andrewnguyen57/stm32-chess-arm/hardware/REV1.md

## Revision 1 of the PCB

### Control 
<p align="center">
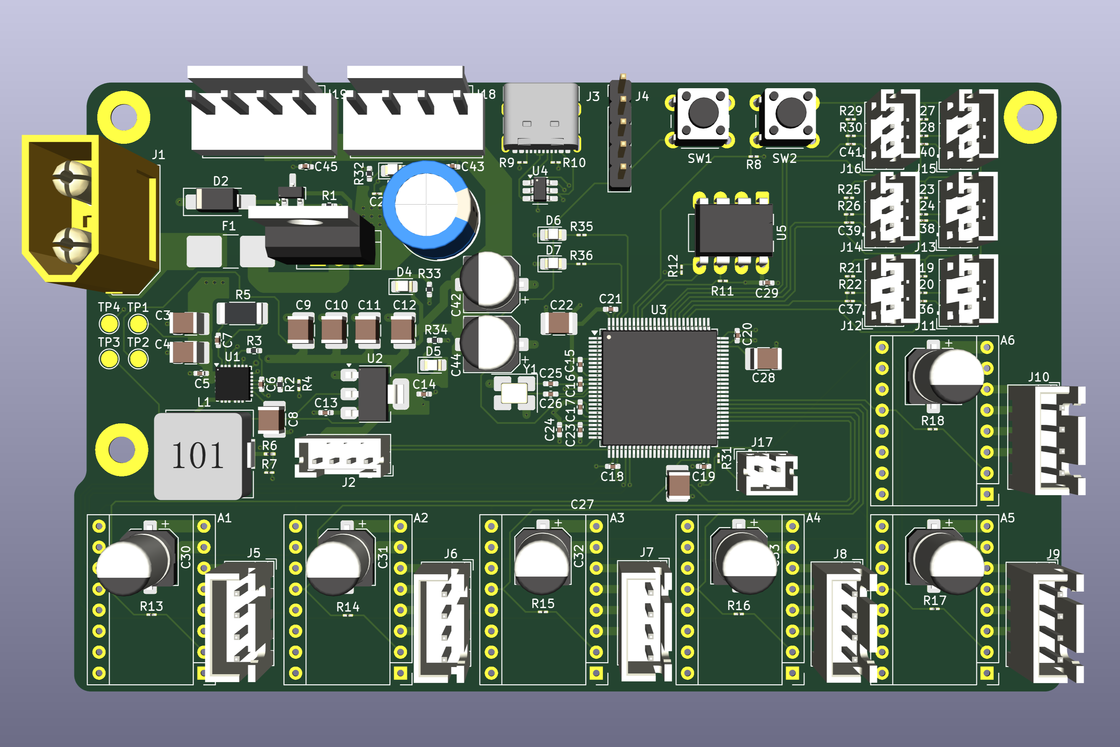
[picture p9: docs/images/pcb-3d_rev1.png]
Control Board 3D
  
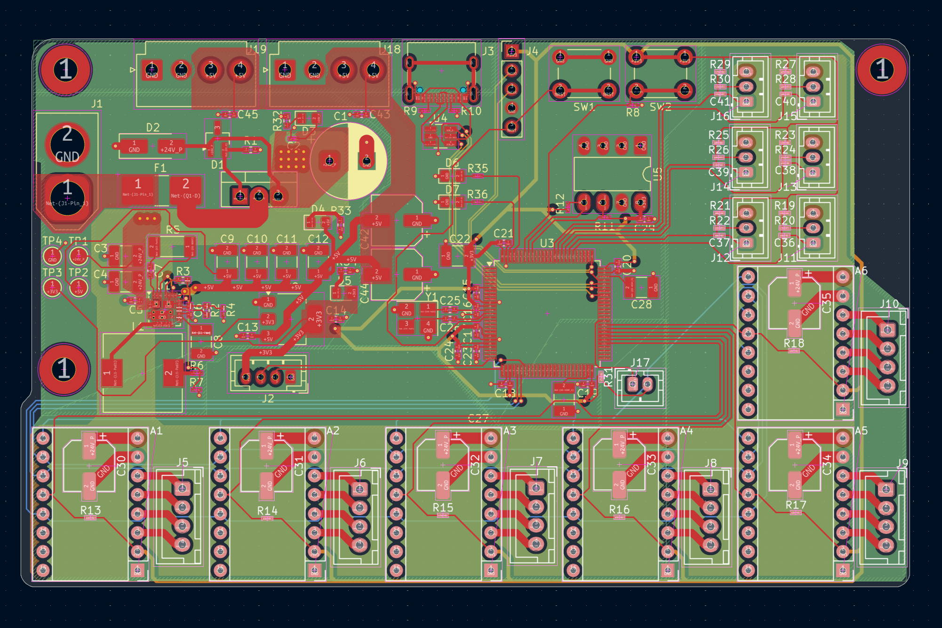
[picture p10: docs/images/pcb-2d_rev1.png]
Control Board 2D
  
</p>

Test
