andrewnguyen57/stm32-chess-arm/docs/images/logic-schematic_rev1.png

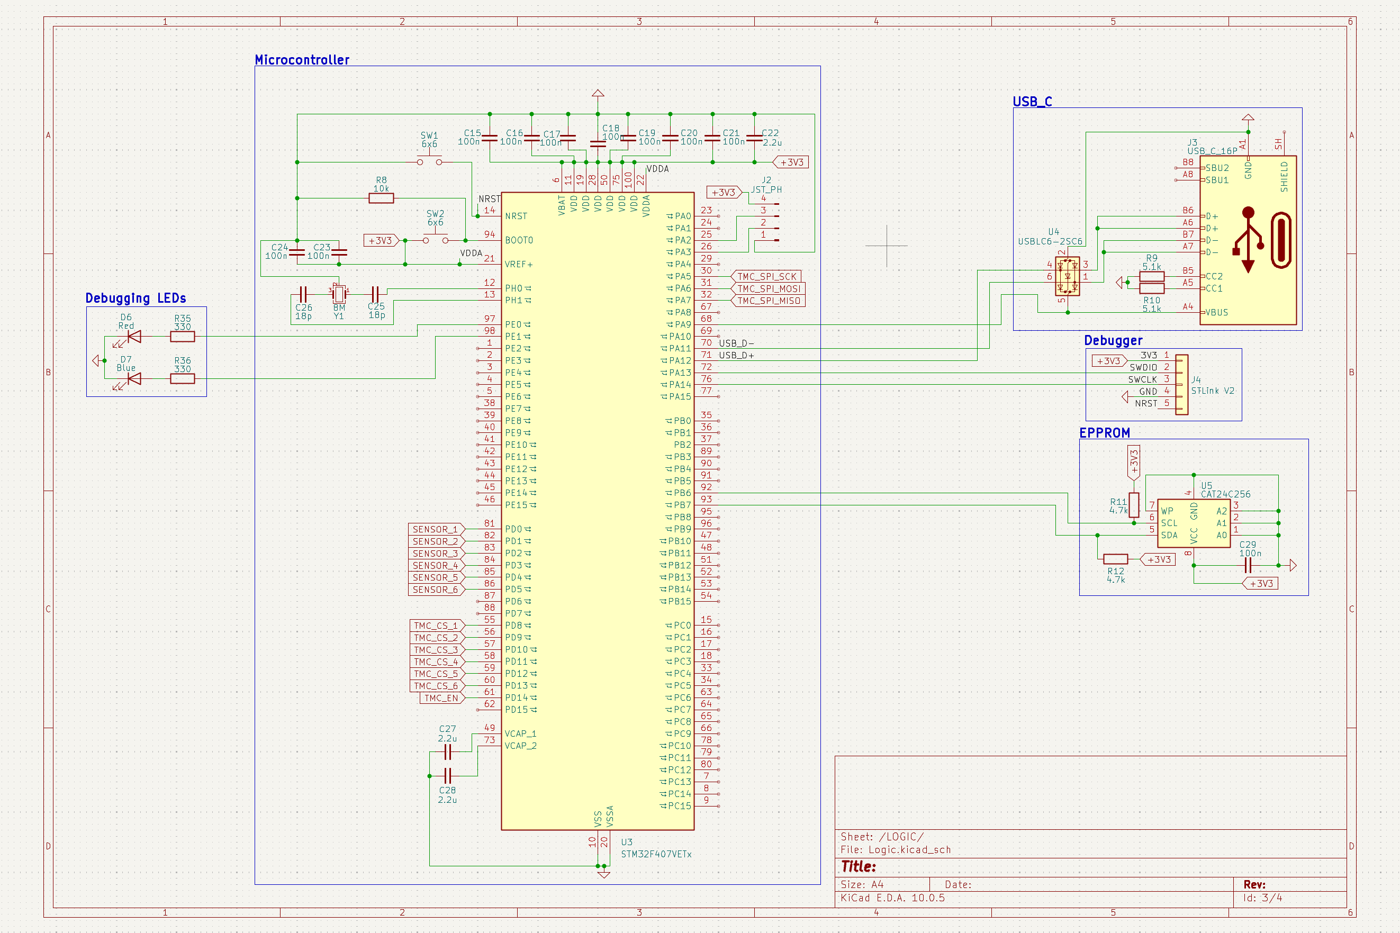
docs/images/logic-schematic_rev1.png
