andrewnguyen57/stm32-chess-arm/docs/images/power-schematic_rev1.png

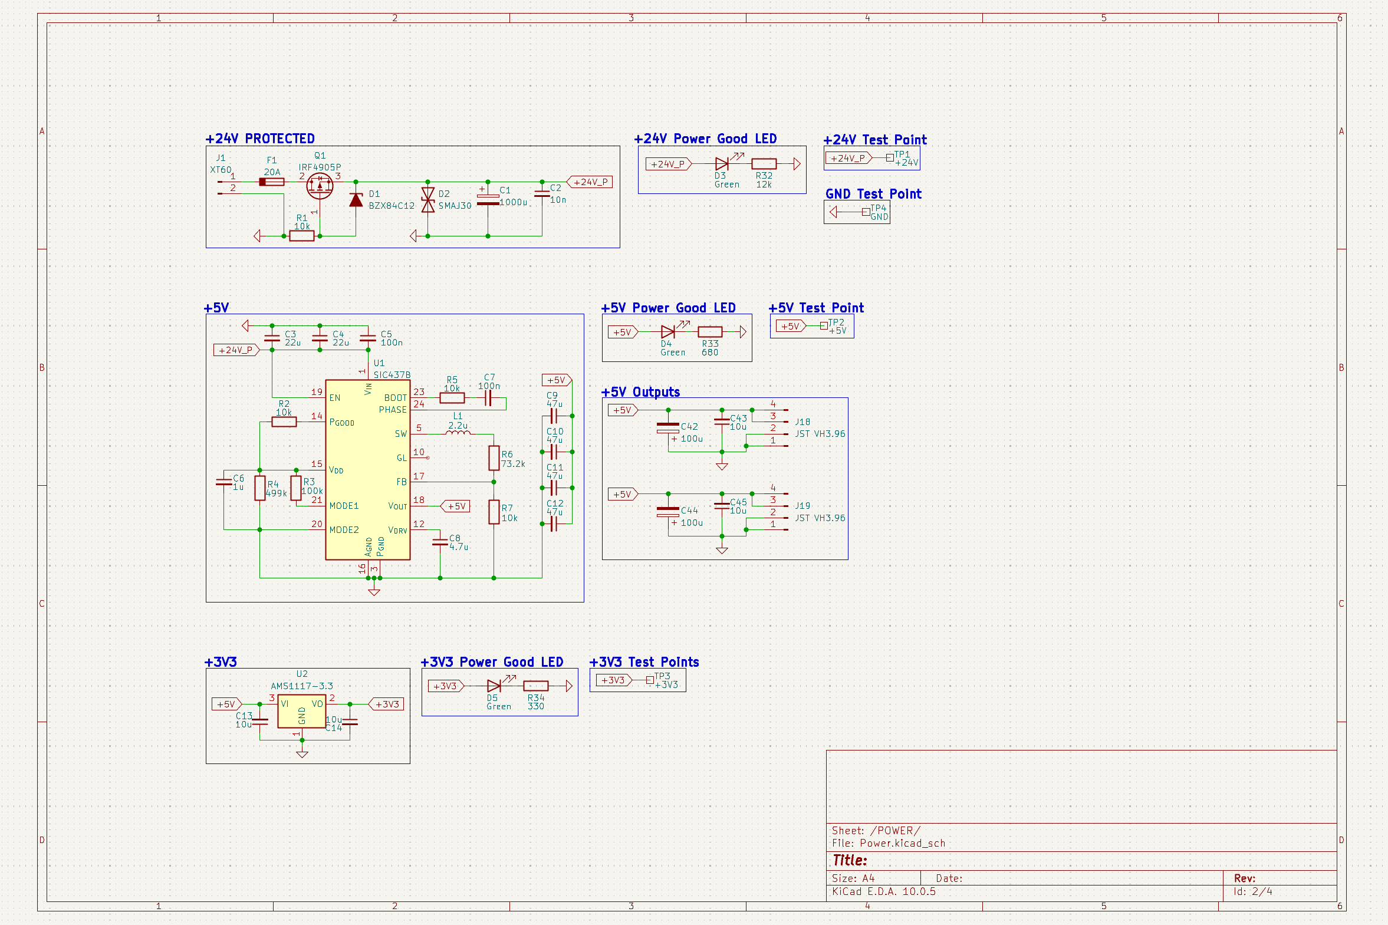
docs/images/power-schematic_rev1.png
