andrewnguyen57/stm32-chess-arm/docs/BOM.md

Capacitor - 0402 - 100nF x 16
Capacitor - 1210 - 2.2uF x 2
Capacitor - 6.3x7.7 - 100uF x 6
Capacitor - 0402 - 18pF x 2
Resistor - 0402 - 10k x 14
Resistor - 0402 - 1k x 6
Resistor - 0402 - 5.1k x 2
Resistor - 0402 - 330 x 2
Resistor - 0402 - 4.7k x 2
Capacitor - Radial - 1000uF
Fuse Holder - https://www.aliexpress.com/item/1005007445051950.html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

Resistor - 0603 - 73.2k
Resistor - 0603 - 499k
