andrewnguyen57/stm32-chess-arm/(notices)

Notices in the files:
README.md:
License: MIT
